pdmcguckian/blackjack-robot/README.md

# Blackjack Robot
ARTOPS is a Blackjack playing robot. It acts as the dealer: shuffling, dealing, and keeping track of the cards - as well as choosing to hit or stick based on its own hand and communicating with the user throughout.

View the full portfolio [here](https://drive.google.com/file/d/1qUU3d7Dx41tJ6x1TIVyFhrrzz99wgykW/view)

ARTOPS - blackjack robot
