pdmcguckian/blackjack-robot/Portfolio.pdf

# ARTOPS

# A Blackjack Playing Robot

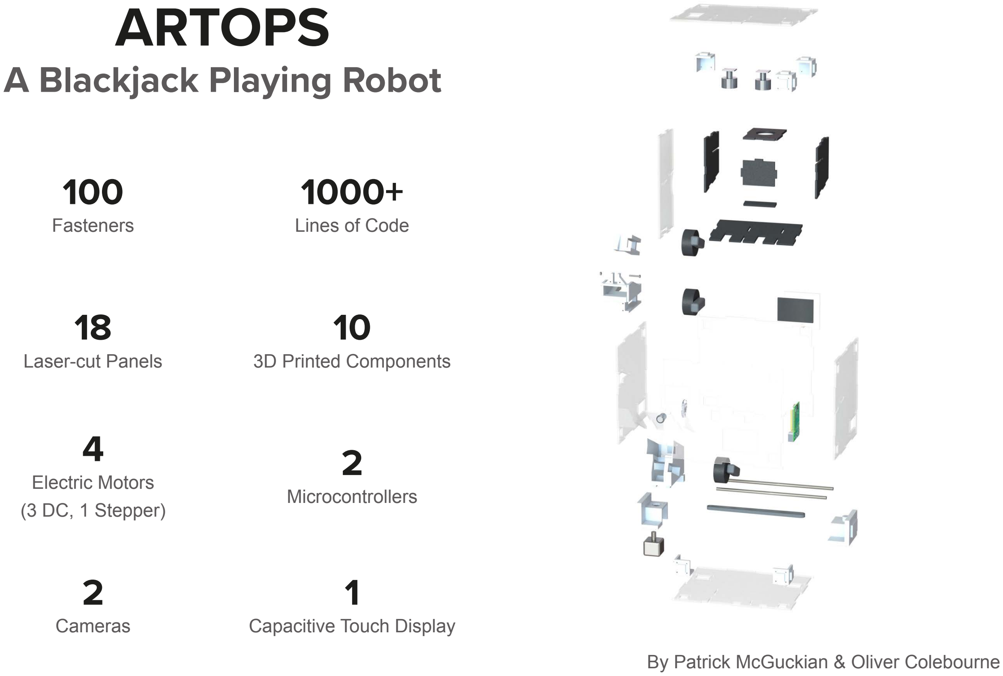
[picture p1: page 1]

100

# Fasteners

1000+

# Lines of Code

18

# Laser-cut Panels

10

# 3D Printed Components

4

# Electric Motors (3 DC, 1 Stepper)

2

# Microcontrollers

2

# Cameras

1

# Capacitive Touch Display By Patrick McGuckian & Oliver Colebourne

## ARTOPS is a Blackjack playing robot. It acts as the dealer: shuffling, dealing, and keeping track of the cards - as well as choosing to hit or stick based on its own hand

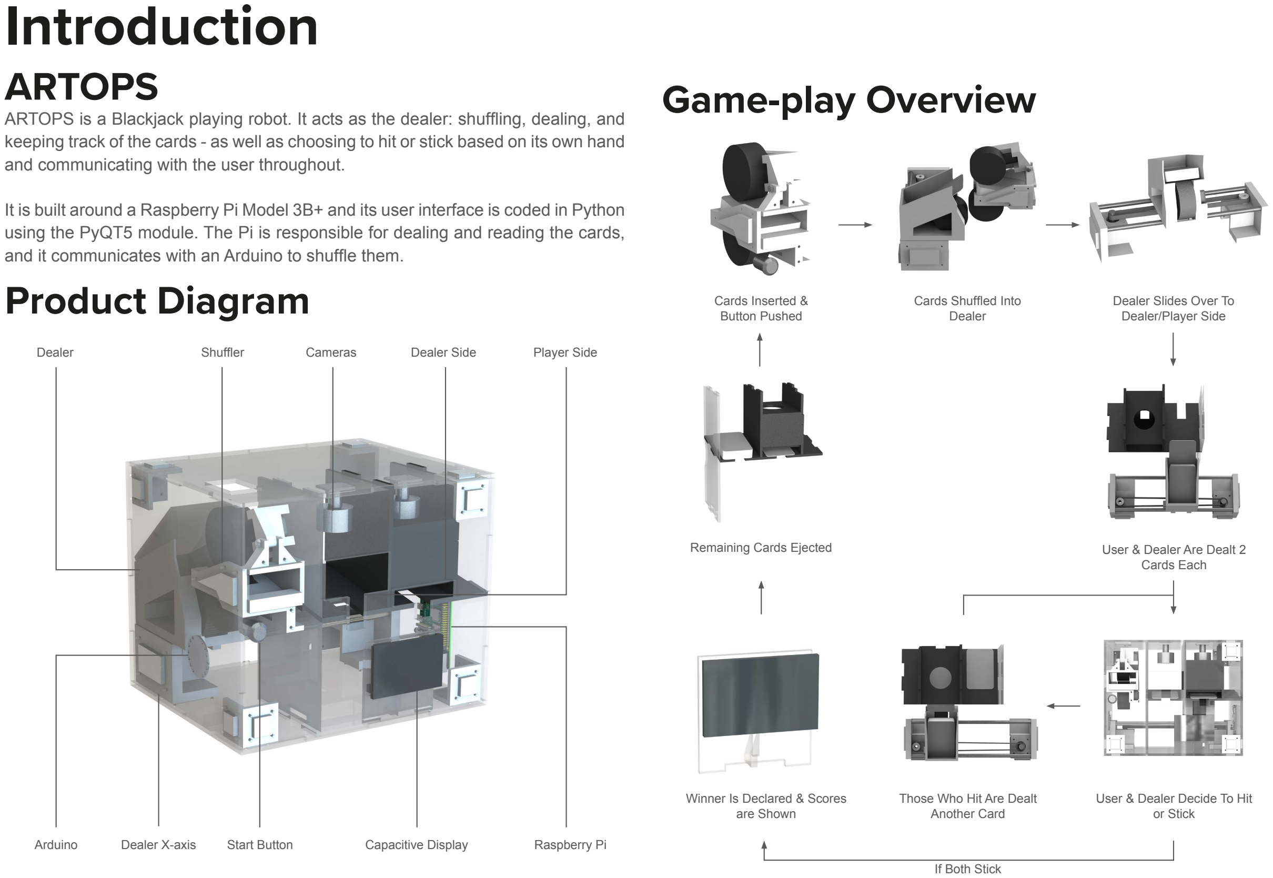
[picture p2: page 2]

and communicating with the user throughout.

## It is built around a Raspberry Pi Model 3B+ and its user interface is coded in Python

using the PyQT5 module. The Pi is responsible for dealing and reading the cards, and it communicates with an Arduino to shuffle them.

# Game-play Overview

Cards Inserted &
Button Pushed

Cards Shuffled Into
Dealer

Dealer Slides Over To
Dealer/Player Side

User & Dealer Are Dealt 2
Cards Each

User & Dealer Decide To Hit or Stick

Those Who Hit Are Dealt
Another Card

Winner Is Declared & Scores are Shown

Remaining Cards Ejected

If Both Stick

Capacitive Display

Dealer | Dealer Side | Player Side

Start Button

Cameras

Arduino | Raspberry Pi

Shuffler

# Product Diagram

Dealer X-axis

# Introduction

# ARTOPS

# Mechatronics

# The Process

## The game of Blackjack requires a dealer to shuffle and deal cards. We developed two separate mechatronic

systems to complete these tasks.

## Playing cards are thin and lightweight meaning they can be extremely difficult to reliably control, and our

design required precise dealing and shuffling.

## After initial sketching we built CAD models and 3D printed a number of prototypes, testing and iterating

them until we had a reliable system.

# Shuffling Cards

## Concept:

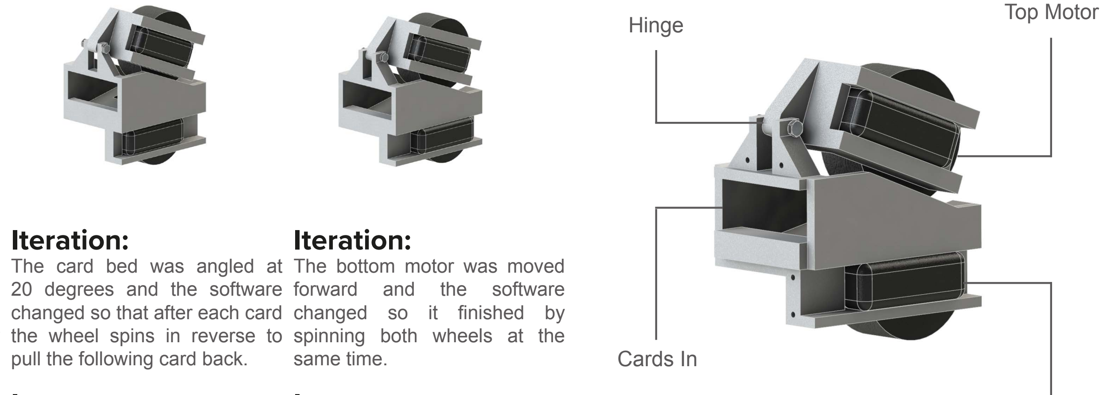
[picture p3: figure]
Iteration: The card bed was angled at 20 degrees and the software changed so that after each card the wheel spins in reverse to pull the following card back.; Iteration: The bottom motor was moved forward and the software changed so it finished by spinning both wheels at the same time.; Top Motor; Cards In; Hinge

The cards sit between two
wheels with the top hinged to always touch the deck. The top or bottom wheel spins randomly 52 times - each time firing a card onto the dealer below.

## Issues:

The cards were being shot out the slot and bottom wheel was moving the entire deck.

## Issues:

Cards fired from the bottom weren’t making it over the edge onto the dealer below & the final few cards were getting stuck.

## Issues:

The design needed changing so it could be fitted to the final product by including screw holes and embossed sections.

# Dealing Cards To Player & User

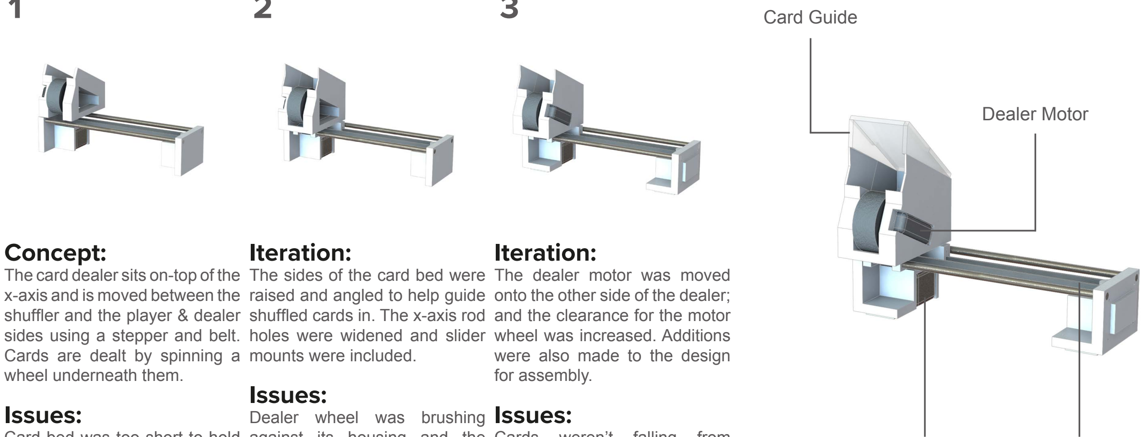
[picture p4: figure]
Concept: The card dealer sits on-top of the x-axis and is moved between the shuffler and the player & dealer sides using a stepper and belt. Cards are dealt by spinning a wheel underneath them. Issues:; Iteration: The sides of the card bed were raised and angled to help guide shuffled cards in. The x-axis rod holes were widened and slider mounts were included. Issues: Dealer wheel was brushing; Iteration: The dealer motor was moved onto the other side of the dealer; and the clearance for the motor wheel was increased. Additions were also made to the design for assembly. Issues:; Dealer Motor; Card Guide
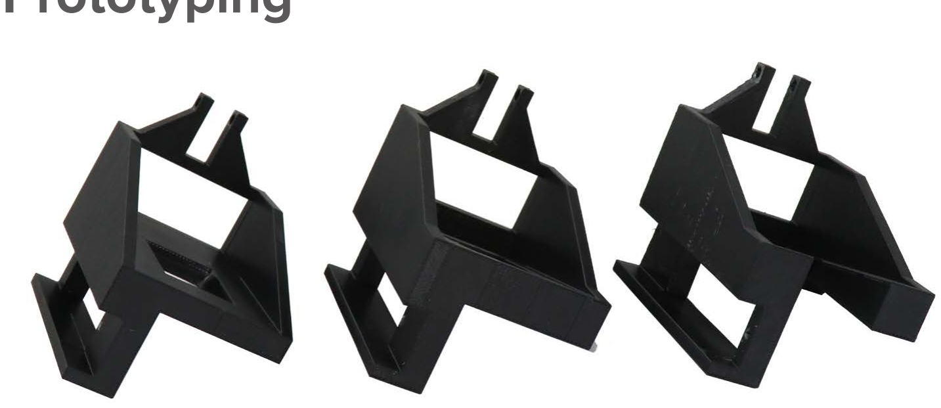
[picture p5: figure]

Card bed was too short to hold the full deck; and metal rods didn’t fit x-axis sides.

against its housing and the motor stuck out too far for dealer to slide flush with casing.

Cards weren’t falling from the shuffler onto the bed
consistently.
1 | 2 | 3
1 | 2 | 3

Bottom Motor

Stepper Motor

Belt

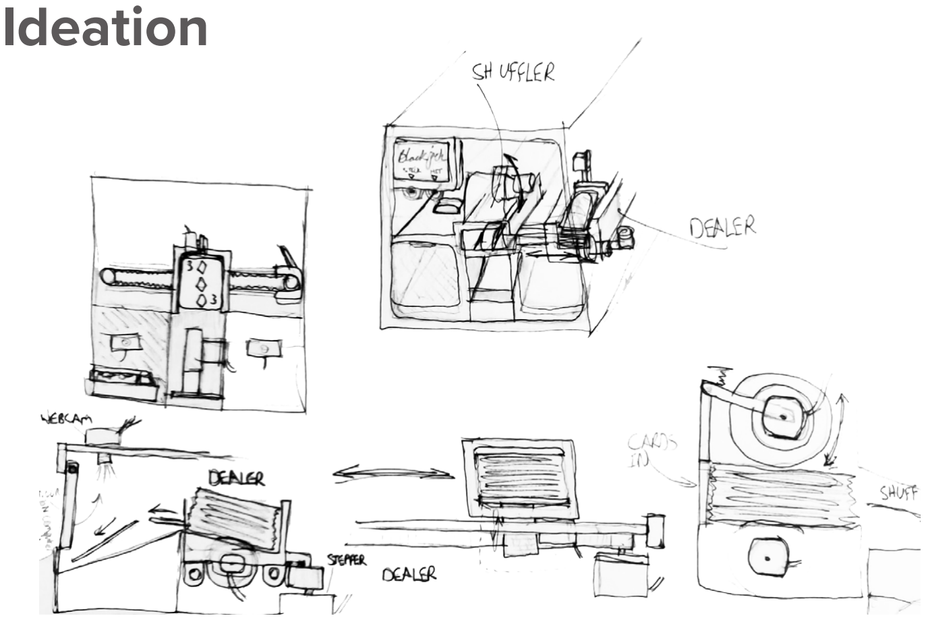
[picture p6: figure]
Ideation

# Prototyping

# Software

# Reading Card Ranks Running The Game

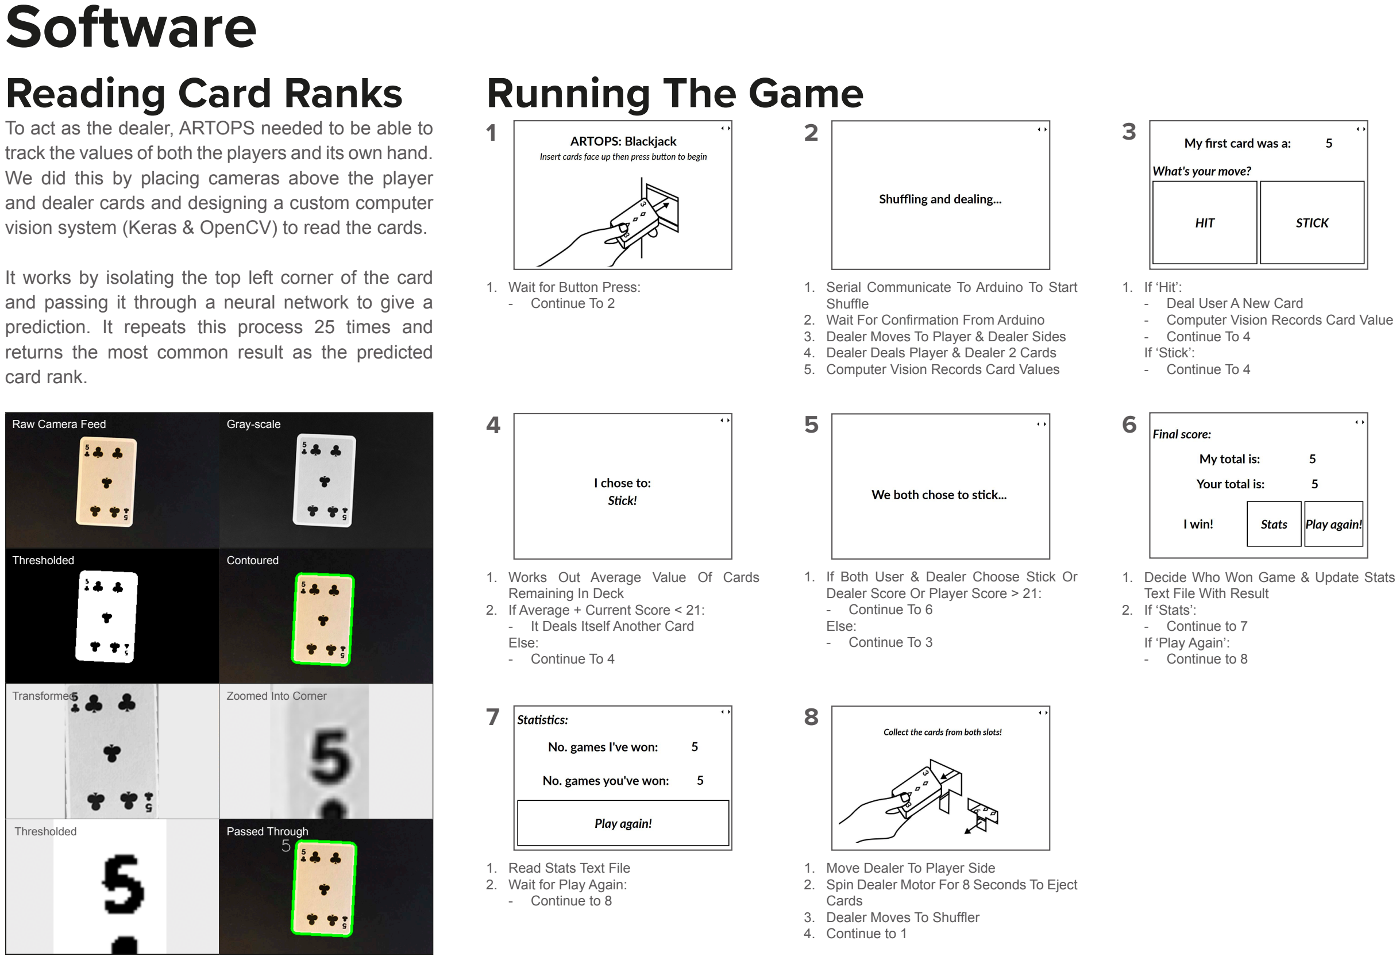
[picture p7: page 4]

1. If ‘Hit’:
- Deal User A New Card
- Computer Vision Records Card Value
- Continue To 4
If ‘Stick’:
- Continue To 4
1. Serial Communicate To Arduino To Start Shuffle
2. Wait For Confirmation From Arduino
3. Dealer Moves To Player & Dealer Sides
4. Dealer Deals Player & Dealer 2 Cards
5. Computer Vision Records Card Values

## To act as the dealer, ARTOPS needed to be able to

track the values of both the players and its own hand.

## We did this by placing cameras above the player and dealer cards and designing a custom computer

vision system (Keras & OpenCV) to read the cards.

## It works by isolating the top left corner of the card and passing it through a neural network to give a prediction. It repeats this process 25 times and returns the most common result as the predicted

card rank.

1. Wait for Button Press:
- Continue To 2
1. Decide Who Won Game & Update Stats Text File With Result
2. If ‘Stats’:
- Continue to 7
If ‘Play Again’:
- Continue to 8
1. Works Out Average Value Of Cards Remaining In Deck
2. If Average + Current Score < 21:
- It Deals Itself Another Card
Else:
- Continue To 4
1. If Both User & Dealer Choose Stick Or Dealer Score Or Player Score > 21:
- Continue To 6
Else:
- Continue To 3
1. Move Dealer To Player Side
2. Spin Dealer Motor For 8 Seconds To Eject Cards
3. Dealer Moves To Shuffler
4. Continue to 1
1. Read Stats Text File
2. Wait for Play Again:
- Continue to 8
1 | 2 | 3
4 | 5 | 6

7 8

Raw Camera Feed | Gray-scale
Thresholded | Contoured
Transformed | Zoomed Into Corner
Thresholded | Passed Through

# Design

# Components Are Structural

To make is easy to see what’s happening inside we wanted as few internal components as possible. So we designed the dealer slider and the shuffler to be part of the assembly of the casing rather then simply screwed onto it.

# Transparent Laser Cut Casing

We wanted the user to be able to see the internal workings of ARTOPS so we made the casing of the product transparent.

# White 3D Printed Components

We 3D Printed all of our internal components to make sure the tolerances were as low as possible. The components used for assembly have 5mm embossed sections that fit precisely into holes cut into the casing, to make sure the fit is as tight as possible.

# A Physical Button

We wanted a tactile interaction with the device so it is started with the press of an inviting glowing mechanical button.

# Prototyped Circuit Boards

We wanted to emphasise the mechatronics and hide the electronics so we built our circuits using prototyping PCBs.

# Ergonomic Card Collection Slots

Raised front stops cards from sliding off the bed while center slots allow for the player to easily lift cards out

# Hidden Dealer Cards

We covered the dealers cards from the user to keep the suspense of traditional card games.

# Sheathed Cables

As the inside of the device visible we needed to make it as tidy as possible. So we sheathed the cables all of the cables.

# Mechanical Fasteners

We wanted to avoid using glue to assemble our casing - so we used machine screws to hold it together.
