pdmcguckian/blackjack-robot/Raspberry-pi/page1graphic.png

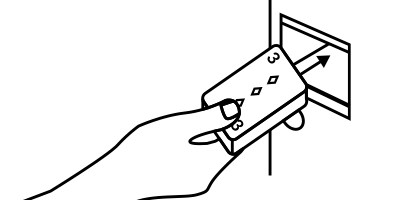
Raspberry-pi/page1graphic.png
