pdmcguckian/blackjack-robot/Raspberry-pi/page9graphic.png

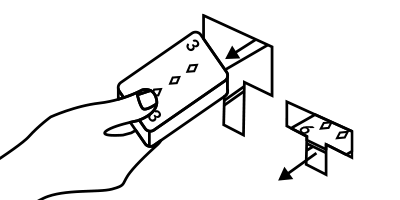
Raspberry-pi/page9graphic.png
